D8aCruz/ME1-R4053-G8/PCB-3d.png

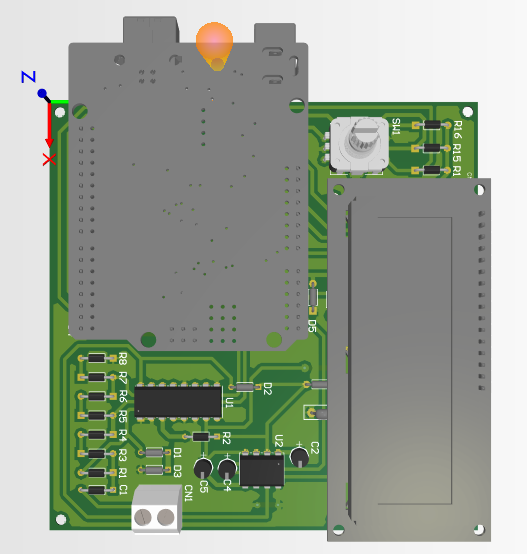
PCB-3d.png
