D8aCruz/ME1-R4053-G8/IMG/Patron.jpg

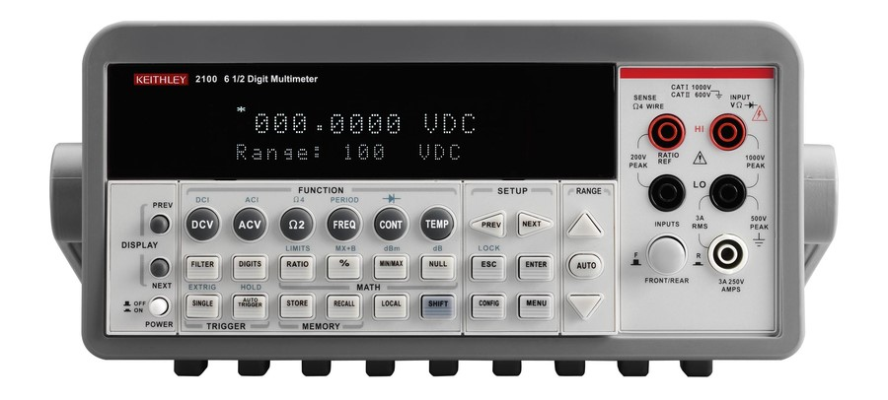
IMG/Patron.jpg
