D8aCruz/ME1-R4053-G8/README.md

<div style="display: flex; flex-direction: column; align-items: center;">
  Logo UTN FRBA
  <hr style="border: ridge #0EEA0B 1px;">
  <p style="font-weight: courier,arial,helvética; text-align: center;"><font color='black'>MEDIDAS ELECTRÓNICAS I</font></p>
  <p style="font-weight: courier,arial,helvética; text-align: center;"><font color='black'>CURSO R4053-2023</font></p>
</div>
