D8aCruz/ME1-R4053-G8/DiagramaDeFlujo.png

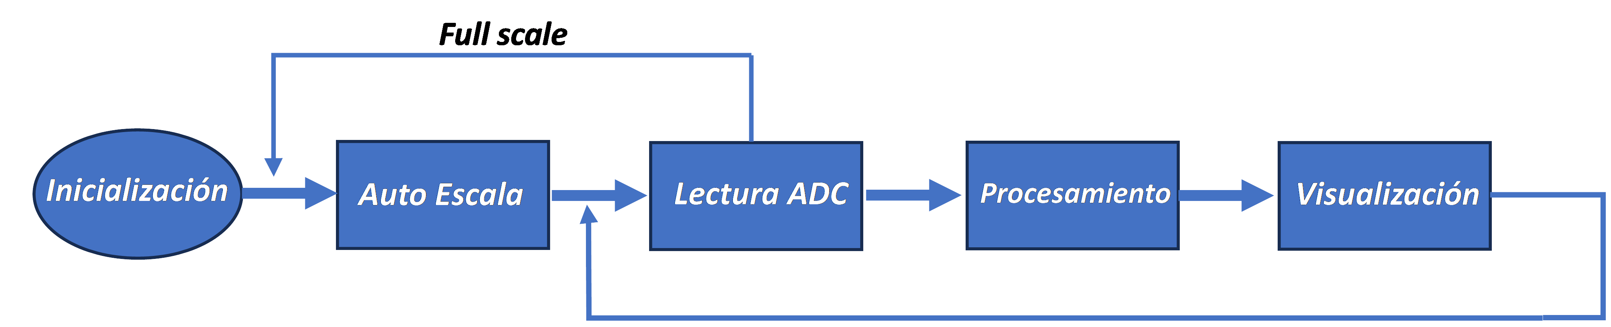
DiagramaDeFlujo.png
