D8aCruz/ME1-R4053-G8/DiagramaEnBloque.jpg

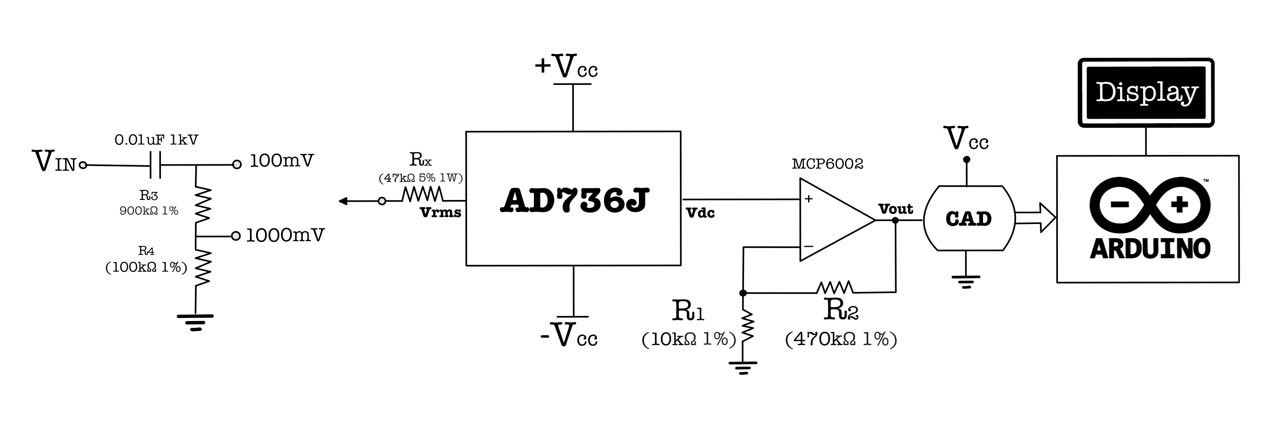
DiagramaEnBloque.jpg
