D8aCruz/ME1-R4053-G8/Equipo-A.jpg

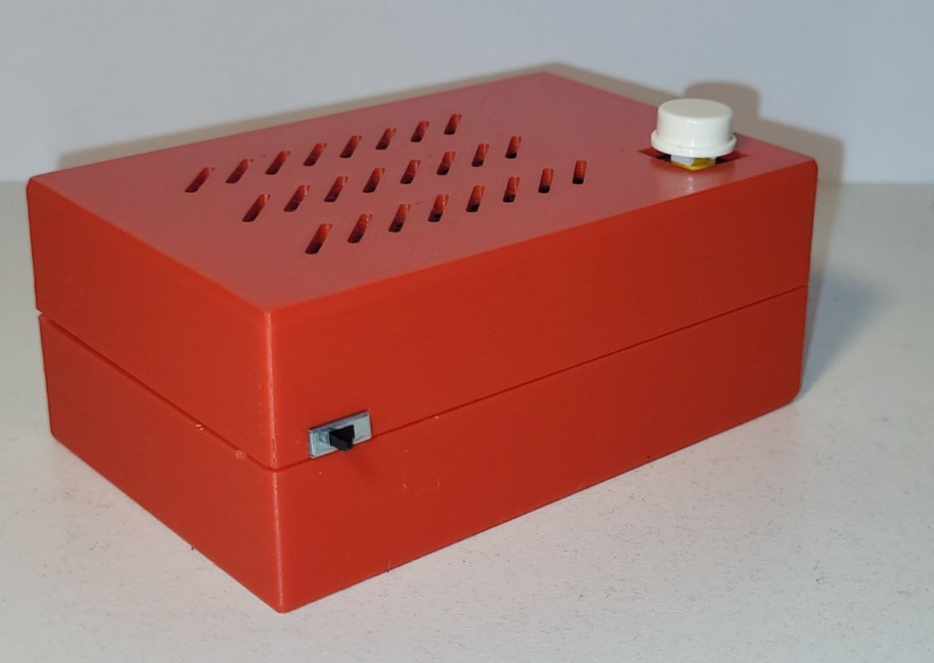
Equipo-A.jpg
