D8aCruz/ME1-R4053-G8/Equipo-B.jpg

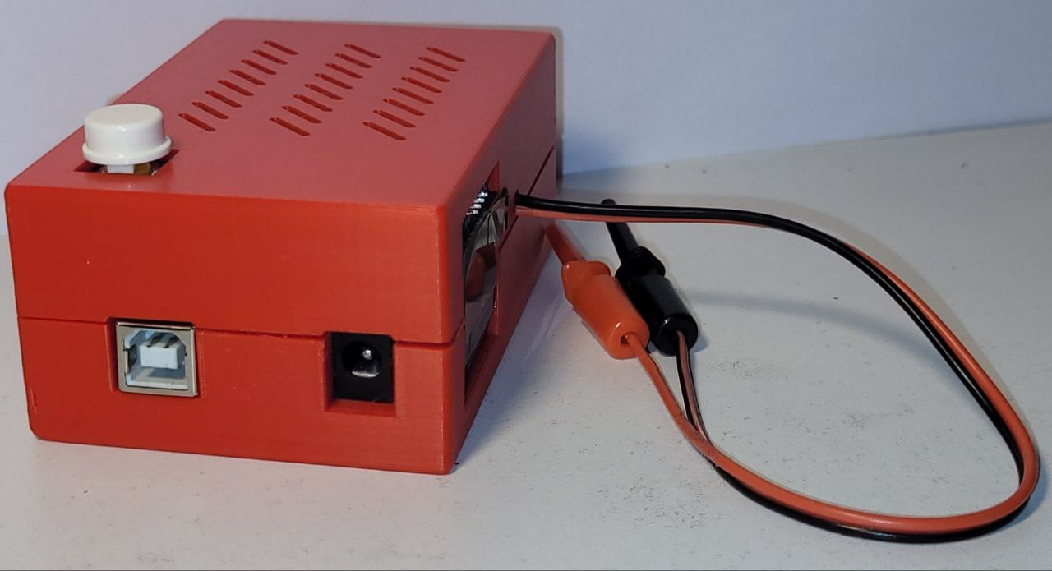
Equipo-B.jpg
