D8aCruz/ME1-R4053-G8/Equipo-C.jpg

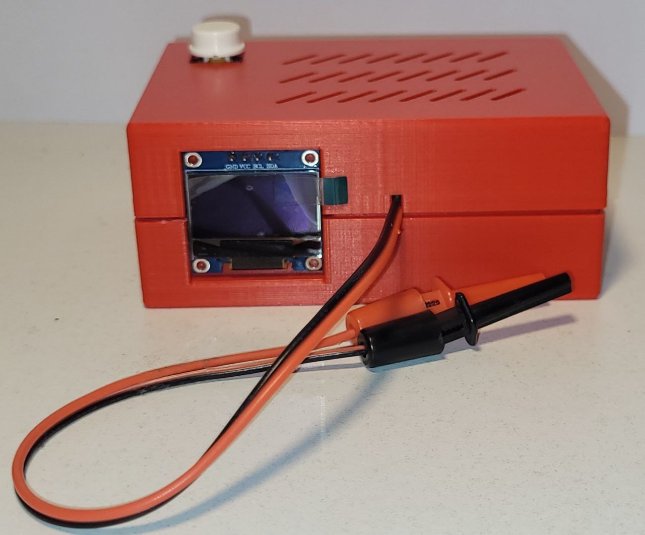
Equipo-C.jpg
