D8aCruz/ME1-R4053-G8/Equipo-D.jpg

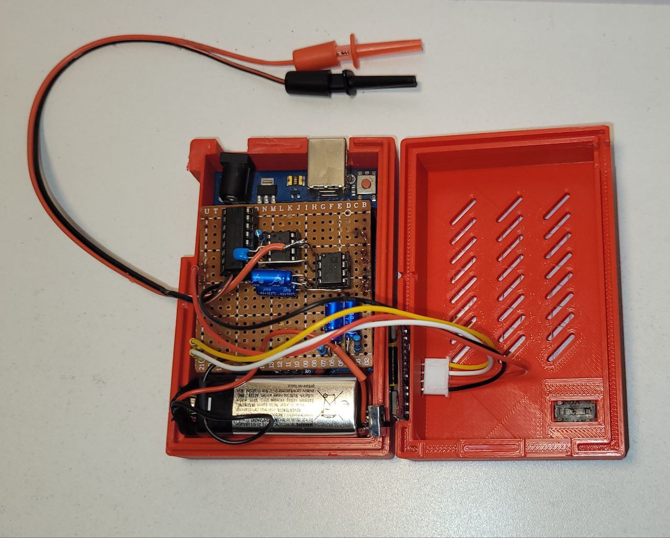
Equipo-D.jpg
