D8aCruz/ME1-R4053-G8/Esquematico-A.png

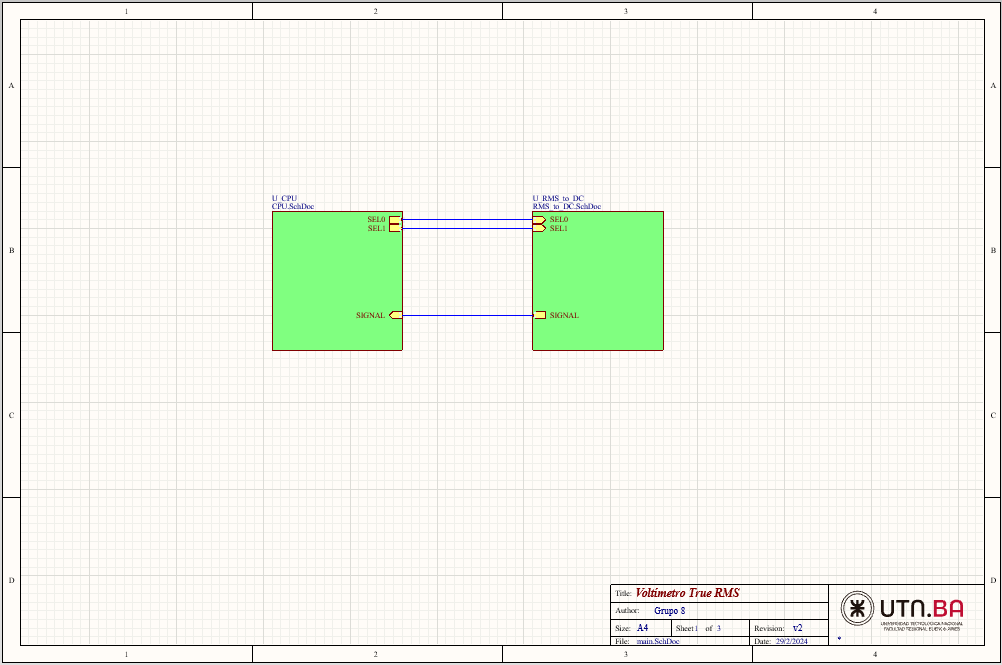
Esquematico-A.png
