D8aCruz/ME1-R4053-G8/Esquematico-B.png

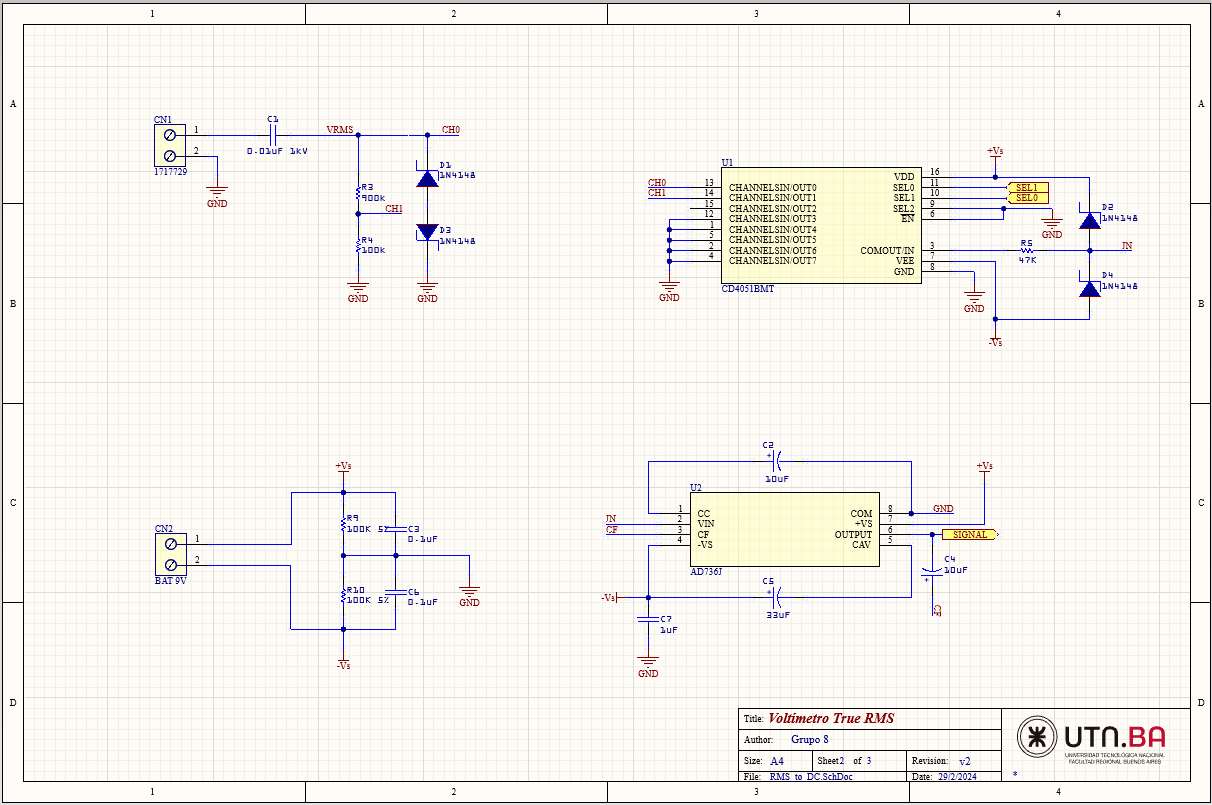
Esquematico-B.png
