D8aCruz/ME1-R4053-G8/Esquematico-C.png

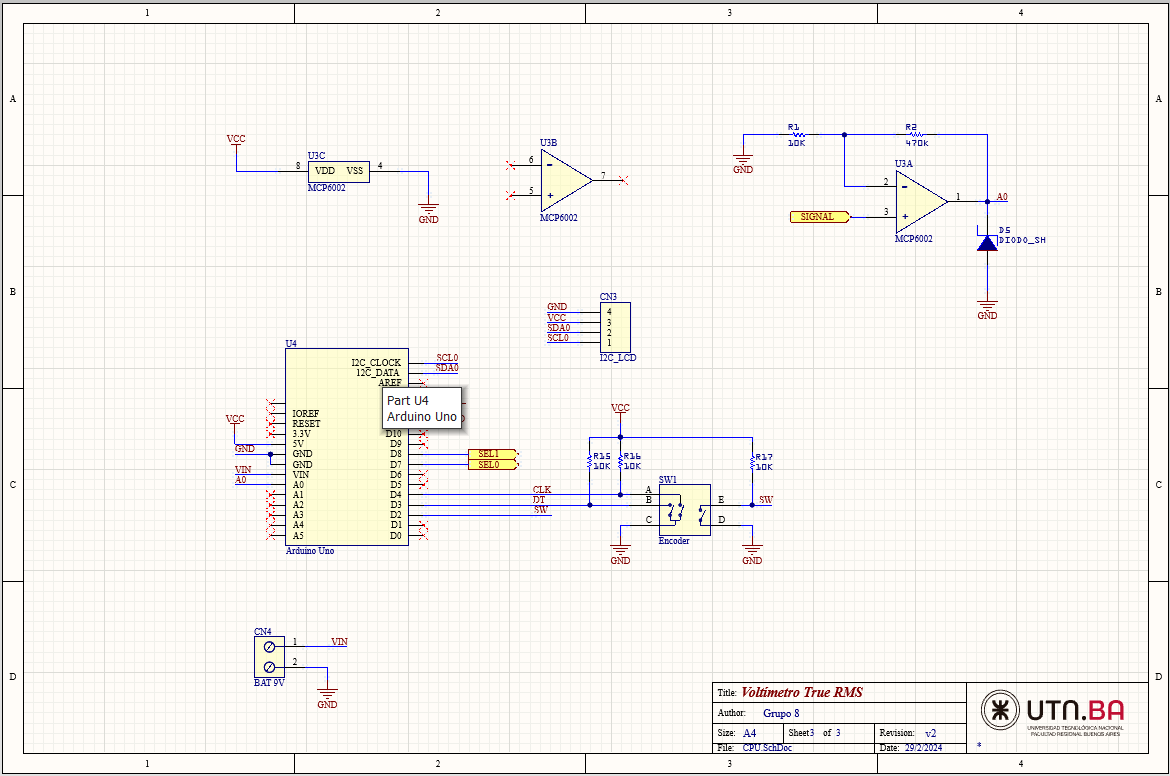
Esquematico-C.png
