D8aCruz/ME1-R4053-G8/FecuenciaVSTension-Grafico.png

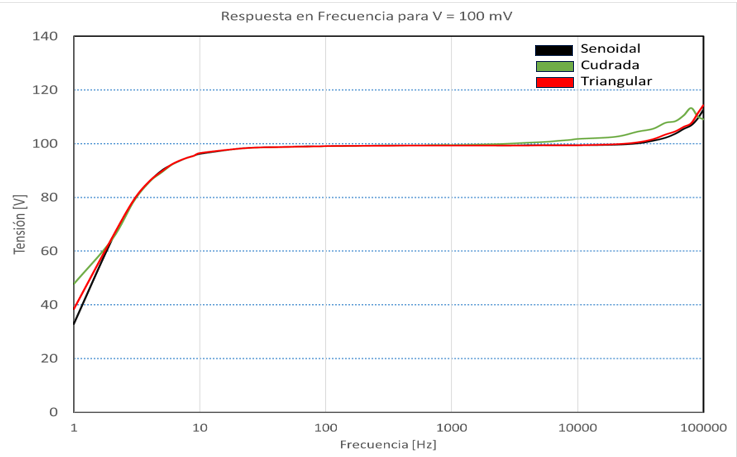
FecuenciaVSTension-Grafico.png
