D8aCruz/ME1-R4053-G8/Grafico-100mV.png

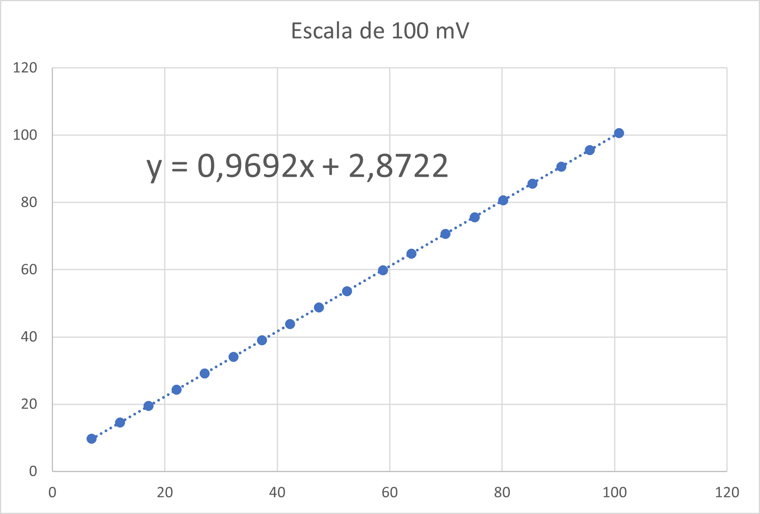
Grafico-100mV.png
