D8aCruz/ME1-R4053-G8/Grafico-1000mV.png

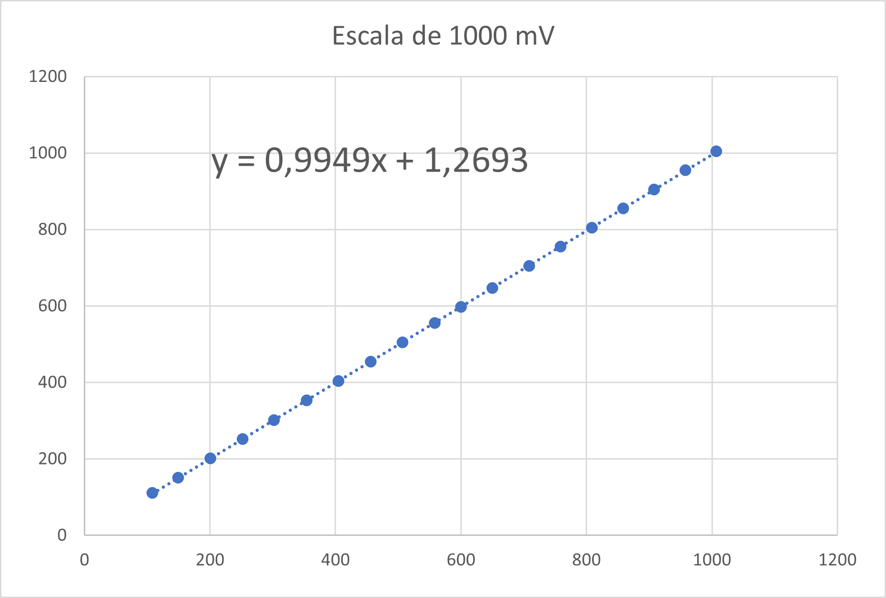
Grafico-1000mV.png
