D8aCruz/ME1-R4053-G8/IMG/PCB-img.png

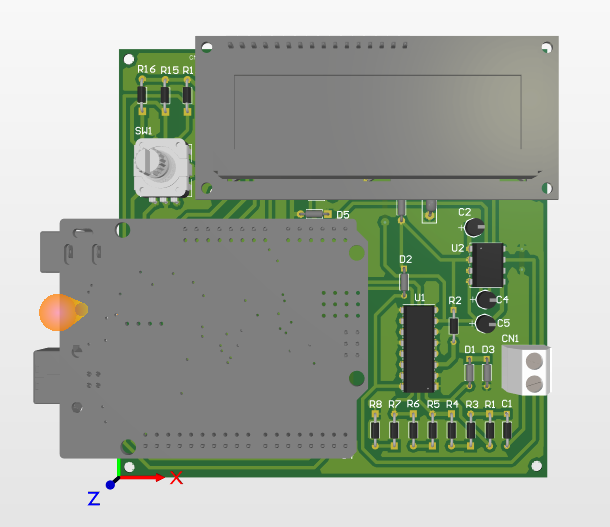
IMG/PCB-img.png
