D8aCruz/ME1-R4053-G8/IMG/PCB.png

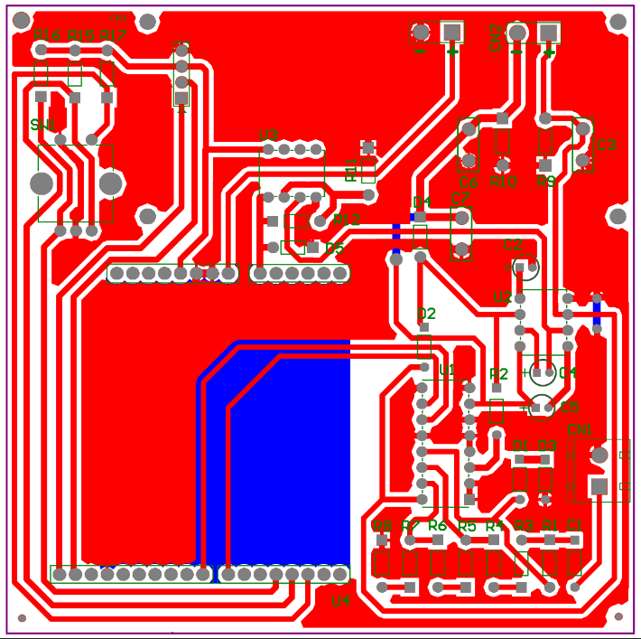
IMG/PCB.png
