D8aCruz/ME1-R4053-G8/KEITHLEY-A.png

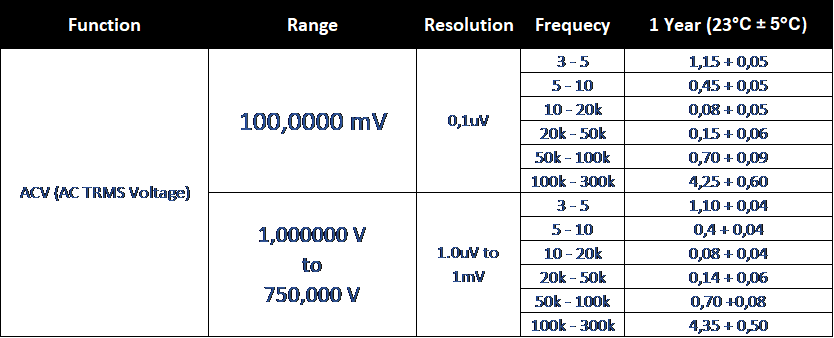
KEITHLEY-A.png
