D8aCruz/ME1-R4053-G8/Tabal-100mV.png

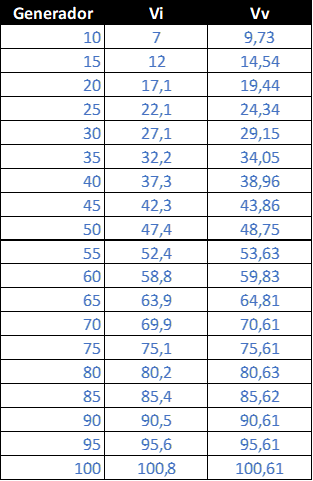
Tabal-100mV.png
