D8aCruz/ME1-R4053-G8/(commit log)

2024-02-26 Proyecto de Medidas 1 = Informe parcialmente terminado
    [MedicionesAD736.xlsx, MedicionesAD736v2.xlsx]
2024-02-26 Proyecto de Medidas 1
2024-02-29 Agregando incertidumbre de la escala 100 mV
